uampio/UAMP-KiCad-Libraries/README.md

# UAMP-KiCad-Libraries
UAMP KiCad Libraries

Warranty

The libraries are provided in the hope that they will be useful, but are provided without warranty of any kind, express or implied.

CI Inspired in [Espressif KiCad libraries](https://github.com/espressif/kicad-libraries)
