uampio/UAMP-KiCad-Libraries/(commit log)

2025-05-02 Update TEN-30-XXXXWIN-6-PINS.kicad_mod
    Updated step location
2025-05-04 Update Wurth_Elektronik.kicad_sym
    Updated refrence
2025-05-04 Create Silergy.kicad_sym
    Added Silergy SY8088 symbol
2025-05-04 Solved issue package reference schematic
2025-05-06 Update Nuvoton.kicad_sym
    Corrected pdf link
2025-06-24 Add ADS1230IPWR symbol to Texas Instruments library
    Introduced the ADS1230IPWR 20-bit ADC symbol with all pins, properties, and footprint to the Texas_Instruments.kicad_sym library for use in schematic designs.
2025-06-24 Add ADS1235IRHBT ADC symbol to TI library
    Introduced the ADS1235IRHBT 24-bit delta-sigma ADC symbol to the Texas Instruments KiCad symbol library, including all pins, properties, and footprint association.
2026-11-10 Fix broken footprint links, 3D model paths and part fields
    - NAU7802SGI: Package_SO:SOP-16_3.9x9.9mm_P1.27mm was removed in KiCad 10;
    use Package_SO:SOIC-16_3.9x9.9mm_P1.27mm (same land pattern within
    0.05 mm, present in KiCad 9 and 10).
    - LM74610-Q1: Package_SO:VSSOP-8_3.0x3.0mm_P0.65mm no longer exists (not
    in KiCad 9.0 either); it is now Package_SO:VSSOP-8_3x3mm_P0.65mm.
    - MAX4690CAE: Supplier name and Supplier part number were swapped
    (now RS / 190-5670).
    - MAX17262: empty Value, now MAX17262.
    - Phoenix 1071010: the 3D model used a custom ${UAMP_LIBRARIES} path; point
    it at the copy in this package like the other footprints.
    - Infineon PG-DSO-8-16: the stock model it referenced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
2026-11-10 Convert the library to KiCad 10
    All symbol and footprint libraries resaved with kicad-cli 10 (symbol format
    20251024, footprint format 20260206). 3D models now load from
    ${KICAD10_3RD_PARTY} (and ${KICAD10_3DMODEL_DIR} for KiCad's stock models).
    The PCM package requires KiCad 10.0.
2026-11-10 Add parts of the CM5 carrier board
    - Raspberry_Pi_Foundation: ComputeModule5-CM5 symbol and footprint (2x Amphenol
    10164227-1001A1RLF receptacles), with the connector and CM5 module 3D models.
    - EDAC: A70-112-331N126 RJ45 MagJack with footprint and 3D model.
    - Microchip: LAN7800-I/Y9X USB 3 to gigabit Ethernet controller, with an SQFN-48
    footprint whose 3D model exists (KiCad's own QFN-48 EP5.3 footprint points at a
    model file that is missing from KiCad 10's library).
    - Texas_Instruments: TPD4EUSB30 4-channel ESD array.
    - Richtek: RT9742SNGV load switch.
    - Traco_Power: TSR 3-2433N (3.3 V 3 A) with footprint and a dimensioned
    14 x 7.6 x 10.2 mm SIP-3 model (KiCad has no model for TSR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
2026-11-10 Fix TMPW10/25/50 pin types
    The AC neutral input was typed power output and -Vout power input, so ERC
    reported shorted power outputs whenever two modules share a mains input. AC N is
    now a power input and -Vout passive.
2026-11-10 Add Bourns, Schurter and Littelfuse fuses with 3D models
    - Bourns MF-MSMF050/30X-2: PTC resettable fuse 0.5 A 30 V, 1812.
    - Schurter 3403.0170.11: UMT 250 SMD fuse 2.5 A time-lag, 250 VAC.
    - Littelfuse 0452004.MRL: NANO2 452 SMD fuse 4 A slow-blow, 2410.
    KiCad's own footprints for these packages have no 3D model; these come with
    dimensioned models made from the datasheet package outlines.
2026-11-13 Add PLC, CM5 carrier and field-connector parts with 3D models
    New parts:
    - Raspberry Pi RP2350B (QFN-80 10x10 mm footprint and STEP)
    - Infineon SLB9672 OPTIGA TPM 2.0 (SPI)
    - ST ISO808 isolated octal high-side switch (PowerSO-36, exposed pad
    with thermal vias; uses KiCad's HSOP-36 SlugUp model because KiCad 10
    ships no SlugDown one)
    - TI HD3SS3212RKS USB 3 mux
    - ATTEND 217C-AE05 mid-mount IP67 USB-C receptacle
    - Binder M12 A-coded and X-coded 8-pin angled sockets
    - JST B2P3-VH, RECOM RPMB3.3-3.0, TDK SIOV CU4032K275G2
